pedrojbm/SparkControl/Firmware/Ignitron/resources/ignitron-cheatsheet.pdf

## BOOT

### https://github.com/stangreg/Ignitron

# CheatSheet

This mode will turn the Ignitron into a Bluetooth LE keyboard. All buttons will act like keyboard presses

In AMP mode, Ignitron acts like a Spark AMP and can communicate with the Spark app running on a mobile. New presets can be stored on Ignitron and existing presets can be deleted.

In Manual/FX mode, you can toggle single effects

In Looper mode, Ignitron is connected to your mobile/PC as a bluetooth keyboard. If supported by the respective app on the mobile/PC, the buttons can be freely configured to any function offered by the respective App.

APP Mode is the default
Ignitron mode.
You can switch presets (1-4) and banks (1-n)

### Short Press Long Press

V1.1 Ivan Tarozzi 2024 | Send “1”
AMP MODE | KEYBOARD MODE
Preset1/Drive | Preset2/Drive Preset3/Drive | Preset4/Drive
| REBOOT | LOOPER MODE

## APP MODE Preset Mode

### Bank Up

### Bank Down

### FX MODE

Send “1” | Send “2” | Send “3” | Send “4”
Send “A” | Send “B” | Send “C” | Send “D”

## KEYBOARD MODE

### Send “6”

### Send “5”

### Send “F”

### Send “E”

Send “1” | Send “2” | Send “3” | Send “4”
| REBOOT | | PRESET MODE

## APP MODE Looper Mode

### Send “6”

### Send “5”

### Next Preset

### Prev. Preset

Drive | Modulation | Delay | Reverb
| REBOOT

## APP MODE Manual/FX Mode

Noise gate

Compressor

PRESET MODE

Sel/Store P1 | Sel/Store P2 | Sel/Store P3 | Sel/Store P4
| REBOOT

## AMP MODE

Bank Up

Bank Down
Unload/Delete
