pedrojbm/SparkControl/Hardware/IMG/skull.png

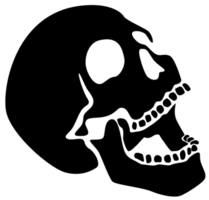
Hardware/IMG/skull.png
