pedrojbm/SparkControl/Hardware/OUT/BLEcontrolV1.xlsx

Comment | Description | Designator | Footprint | JLCPCB Part #（optional）
BH-18650-B1BA002 | BH-18650-B1BA002 | BT1 | BH-18650-B1BA002 | C2988620
1 µF | CAP CER 1UF 25V X7R 0603 | C1, C5, C6, C9 | CAP 0603_1608 | C3015156
4.7 µF | CAP CER 4.7UF 16V X6S 0603 | C2, C3 | CAP 0603_1608 | C3015159
0.1 µF | CAP CER 0.1UF 10V X7R 0603, CAP CER 0.1UF 50V X7R 0603 | C4, C7, C8, C10, C11 | CAP 0603_1608 | C577419
USBLC6-2SC6 | Very low capacitance ESD protection, 3.5 pF, -40 to 125 degC, 6-Pin SOT23, RoHS, Tape and Reel | D1 | SOT95P280X145-6N | C2827654
Blue | LED BLUE 0603 SMD | ON | LED 0603_1608 BLUE | C375446
USB-TYPE-C-017 | 3A 1 Surface Mount 16P Female -25℃~+85℃ Type-C SMD USB Connectors ROHS | J1 | USB-TYPE-C-017 | C2927037
S8050 | Transistor | Q1, Q2 | SOT95P240X115-3N | C364312
4.7 kΩ | RES SMD 4.7K OHM 0.1% 1/10W 0603 | R1, R2, R6, R9, R10, R11, R12, R13, R14, R15, R16, R17, R18 | RES 0603_1608 | C3017722
5.1 kΩ | RES 5.1K OHM 5% 1/10W 0603 | R3, R4 | RES 0603_1608 | C3152170
10 kΩ | RES SMD 10K OHM 1% 1/10W 0603 | R5 | RES 0603_1608 | C2906982
47 kΩ | RES SMD 47K OHM 5% 1/4W 0603 | R7 | RES 0603_1608 | C3152144
1.78 kΩ | RES 1.78K OHM 1% 1/8W 0603 | R8 | RES 0603_1608 | C2974030
12 kΩ | RES 12K OHM 5% 1/10W 0603 | R19, R20, R24, R25 | RES 0603_1608 | C2907097
470 Ω | RES 470 OHM 5% 1/10W 0603 | R21, R22, R23 | RES 0603_1608 | C3017744
BQ24075RGTR | Standalone 1-cell 1.5-A linear charger, Power Path, 4.2-V VBAT and 5.5-V VOUT 16-VQFN -40 to 85 | U1 | QFN50P300X300X100-17N | C15464
ME6211C33M5G-N | Fixed 6V 3.3V 500mA SOT-23-5 Low Dropout Regulators(LDO) RoHS | U2 | SOT95P270X145-5N | C82942
MAX17048G+ | Battery Battery Monitor IC Lithium-Ion 8-TDFN-EP _2x2_ | U3 | SON50P200X200X80-9N | C2682616
ESP32-WROOM-32E_(16MB) | Bluetooth, WiFi 802.11b/g/n, Bluetooth v4.2 +EDR, Class 1, 2 and 3 Transceiver Module 2.4GHz ~ 2.5GHz Integrated, Trace Surface Mount | U4 | XCVR_ESP32-WROOM-32E_(16MB) | C701343
CH340C | USB to serial chip CH340 | U5 | SOIC127P600X180-16N | C7464026
