pedrojbm/SparkControl/Case/Switch/TopCase.SLDPRT

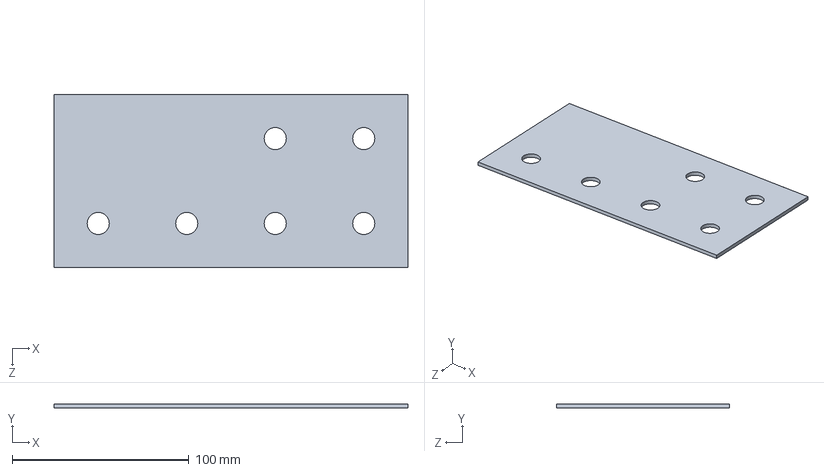
[picture p7: CAD file, 2024-01-24]
Case/Switch/TopCase.SLDPRT
200.0 x 2.54 x 98.0 mm
