pedrojbm/SparkControl/Firmware/Ignitron/hardware/tinyOledBezel.stl

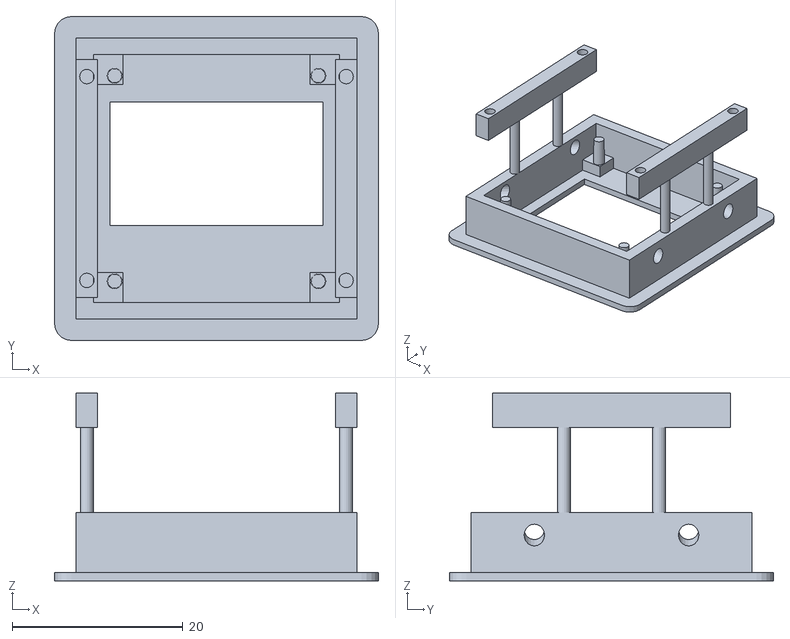
[picture p8: CAD file, 2024-01-24]
Firmware/Ignitron/hardware/tinyOledBezel.stl
38.0 x 38.0 x 22.0
