pedrojbm/SparkControl/Case/AKMAX_Botton.3mf

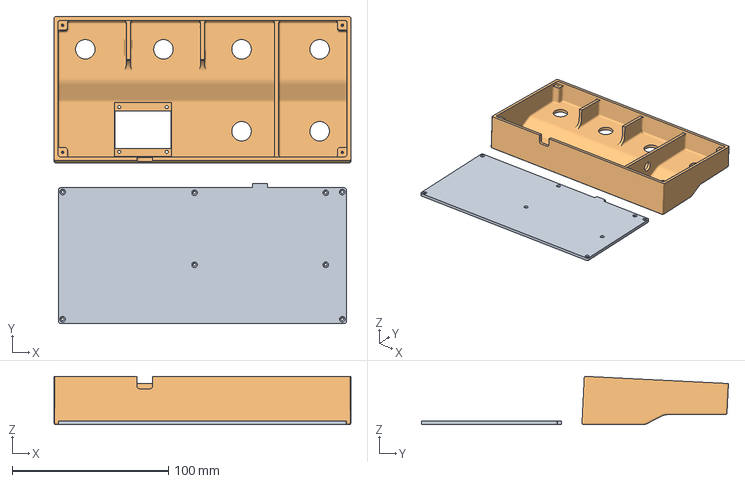
[picture p9: CAD file, 2024-01-24]
Case/AKMAX_Botton.3mf
190.0 x 196.5 x 31.0 mm
Botton.STL
TopCaseV2.STL
