pedrojbm/SparkControl/Case/Botton.SLDPRT

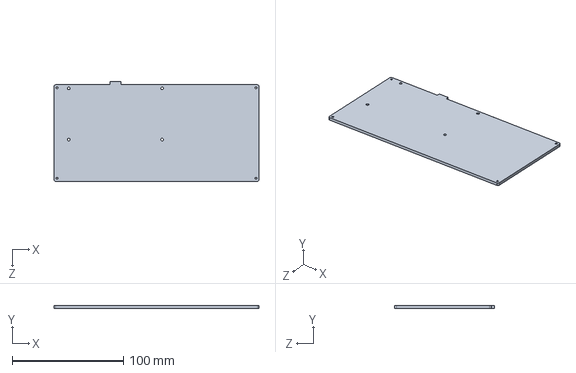
[picture p10: CAD file, 2024-01-24]
Case/Botton.SLDPRT
184.5 x 2.50 x 89.7 mm
