pedrojbm/SparkControl/Case/USB-C and flexed cable.step

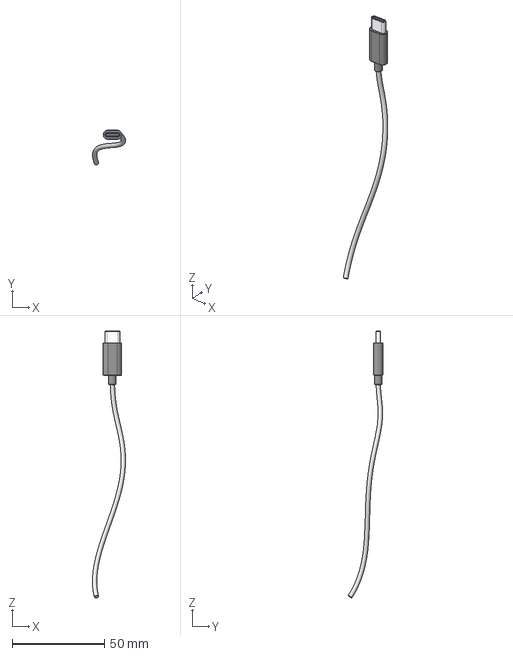
[picture p11: CAD file, 2024-01-24]
Case/USB-C and flexed cable.step
17.9 x 18.8 x 144.6 mm
