pedrojbm/SparkControl/Case/AZ-Delivery - OLED13 IIC.stp

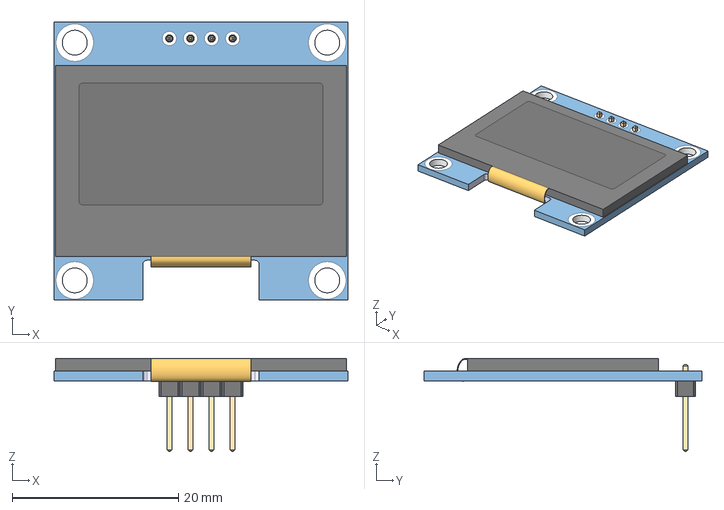
[picture p12: CAD file, 2024-01-24]
Case/AZ-Delivery - OLED13 IIC.stp
35.4 x 33.5 x 11.2 mm
