pedrojbm/SparkControl/Case/Switch/Momentary footswitch.step

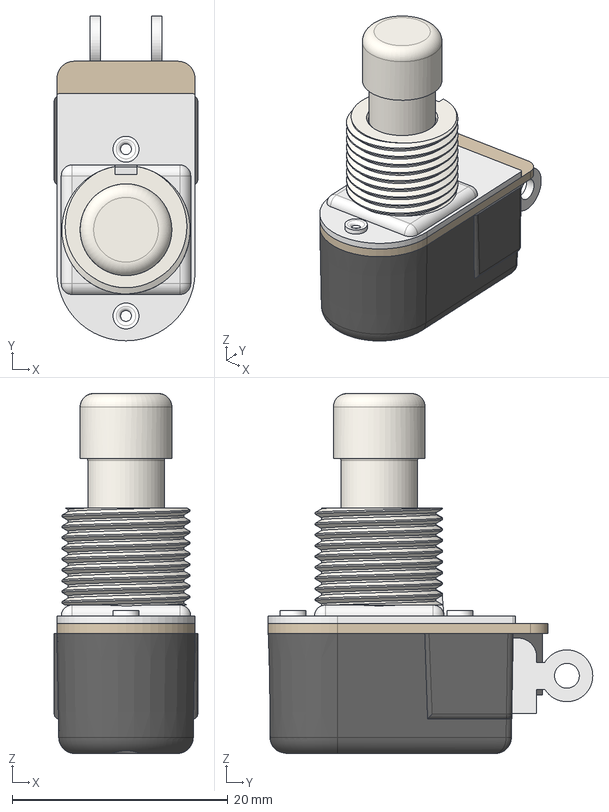
[picture p13: CAD file, 2024-01-24]
Case/Switch/Momentary footswitch.step
13.3 x 30.1 x 33.4 mm
