pedrojbm/SparkControl/Case/Switch/TopCaseV2.SLDPRT

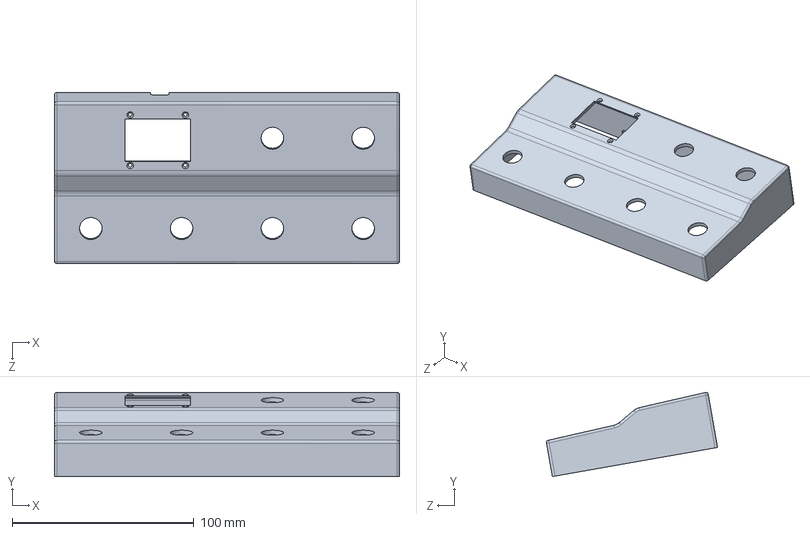
[picture p14: CAD file, 2024-01-24]
Case/Switch/TopCaseV2.SLDPRT
190.0 x 46.3 x 94.3 mm
