pedrojbm/SparkControl/Case/18650 battery.sldprt

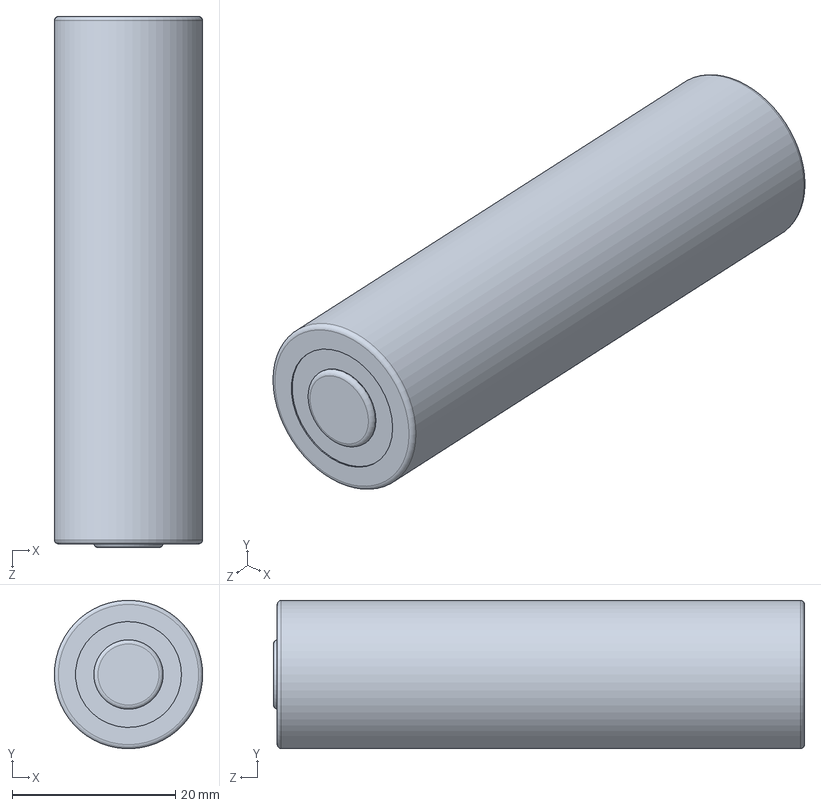
[picture p15: CAD file, 2024-01-24]
Case/18650 battery.sldprt
18.2 x 18.2 x 65.2 mm
