pedrojbm/SparkControl/Case/Switch/M12x1 nut.step

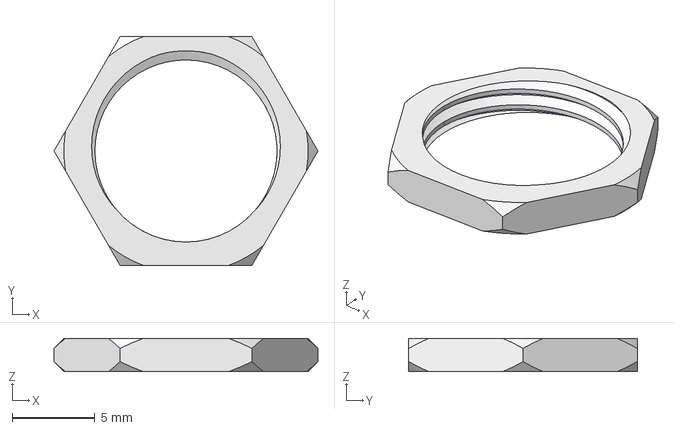
[picture p16: CAD file, 2024-01-24]
Case/Switch/M12x1 nut.step
16.0 x 13.9 x 2.00 mm
