pedrojbm/SparkControl/Case/Switch/12mm spring washer.step

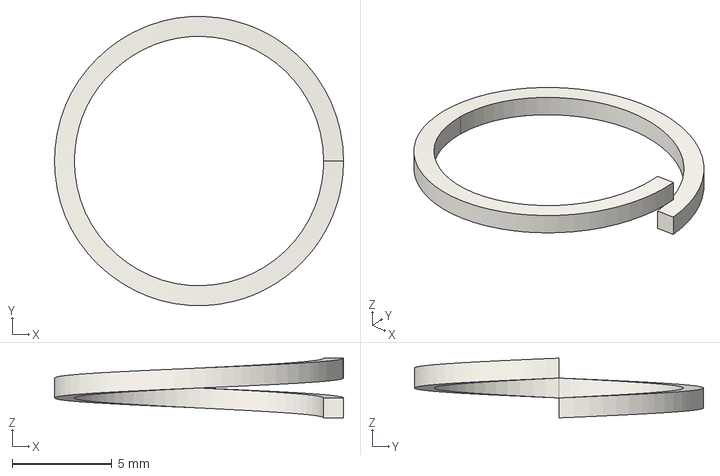
[picture p17: CAD file, 2024-01-24]
Case/Switch/12mm spring washer.step
14.5 x 14.5 x 3.00 mm
