pedrojbm/SparkControl/Case/Switch/M12x1 knurled thumb nut.step

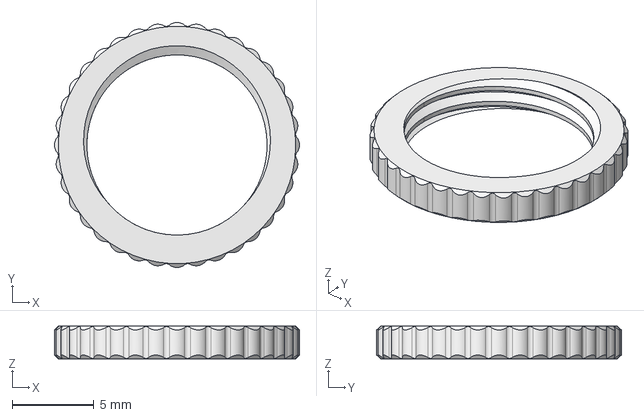
[picture p18: CAD file, 2024-01-24]
Case/Switch/M12x1 knurled thumb nut.step
15.0 x 15.0 x 2.00 mm
