pedrojbm/SparkControl/(list of files, cad)

Other CAD files:
Firmware/Ignitron/hardware/tinyOledBezel.scad
Case/Botton.STL
Case/Switch/12mm spring washer.f3d
Case/Switch/M12x1 knurled thumb nut.f3d
Case/Switch/M12x1 nut.f3d
Case/Switch/Momentary footswitch.f3d
Hardware/PCB/SparkControl_V0.1.x_t
