pedrojbm/SparkControl/Case/Switch/Momentary footswitch assembly.png

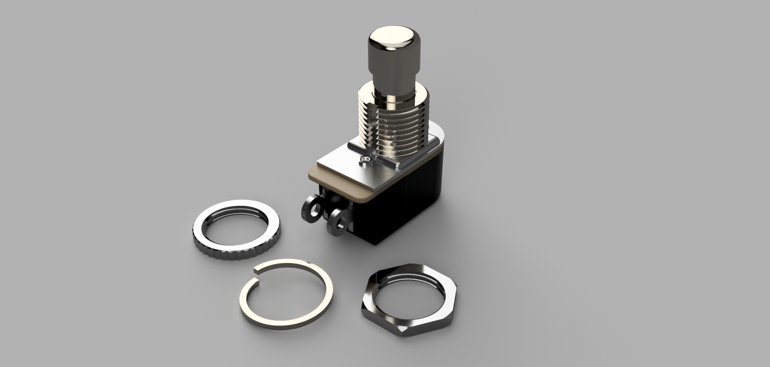
Case/Switch/Momentary footswitch assembly.png
