pedrojbm/SparkControl/Hardware/OUT/SparkControlV1_SCHs.PDF

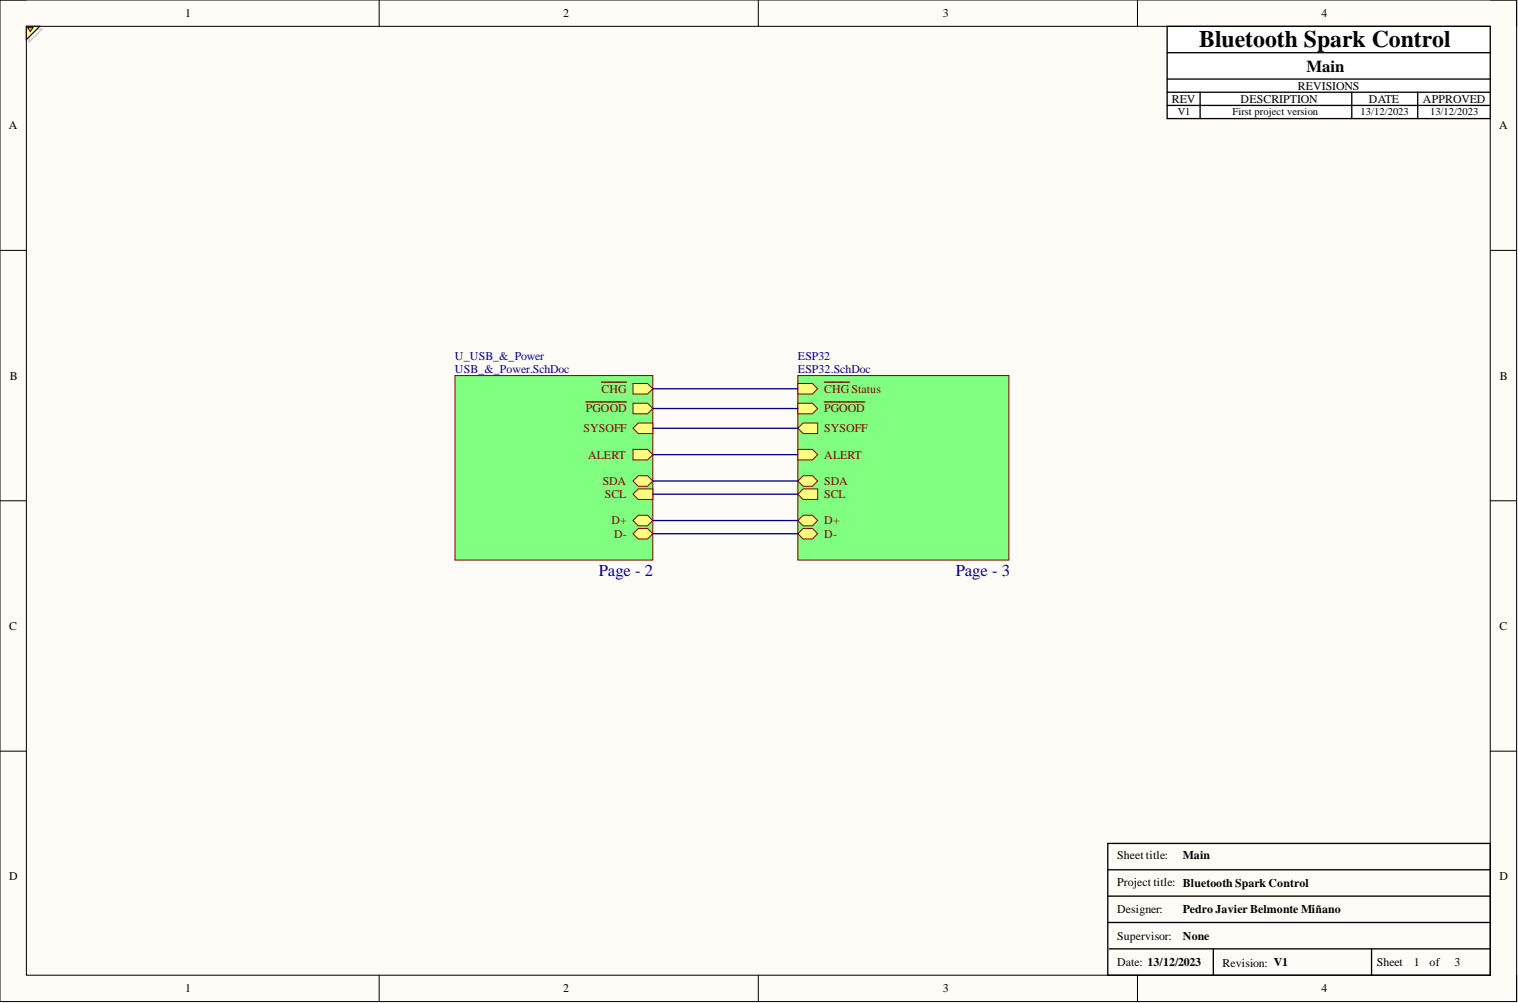
[picture p21: page 1]

REV | DESCRIPTION | DATE | APPROVED
V1 | First project version | 13/12/2023 | 13/12/2023

Pedro Javier Belmonte Miñano

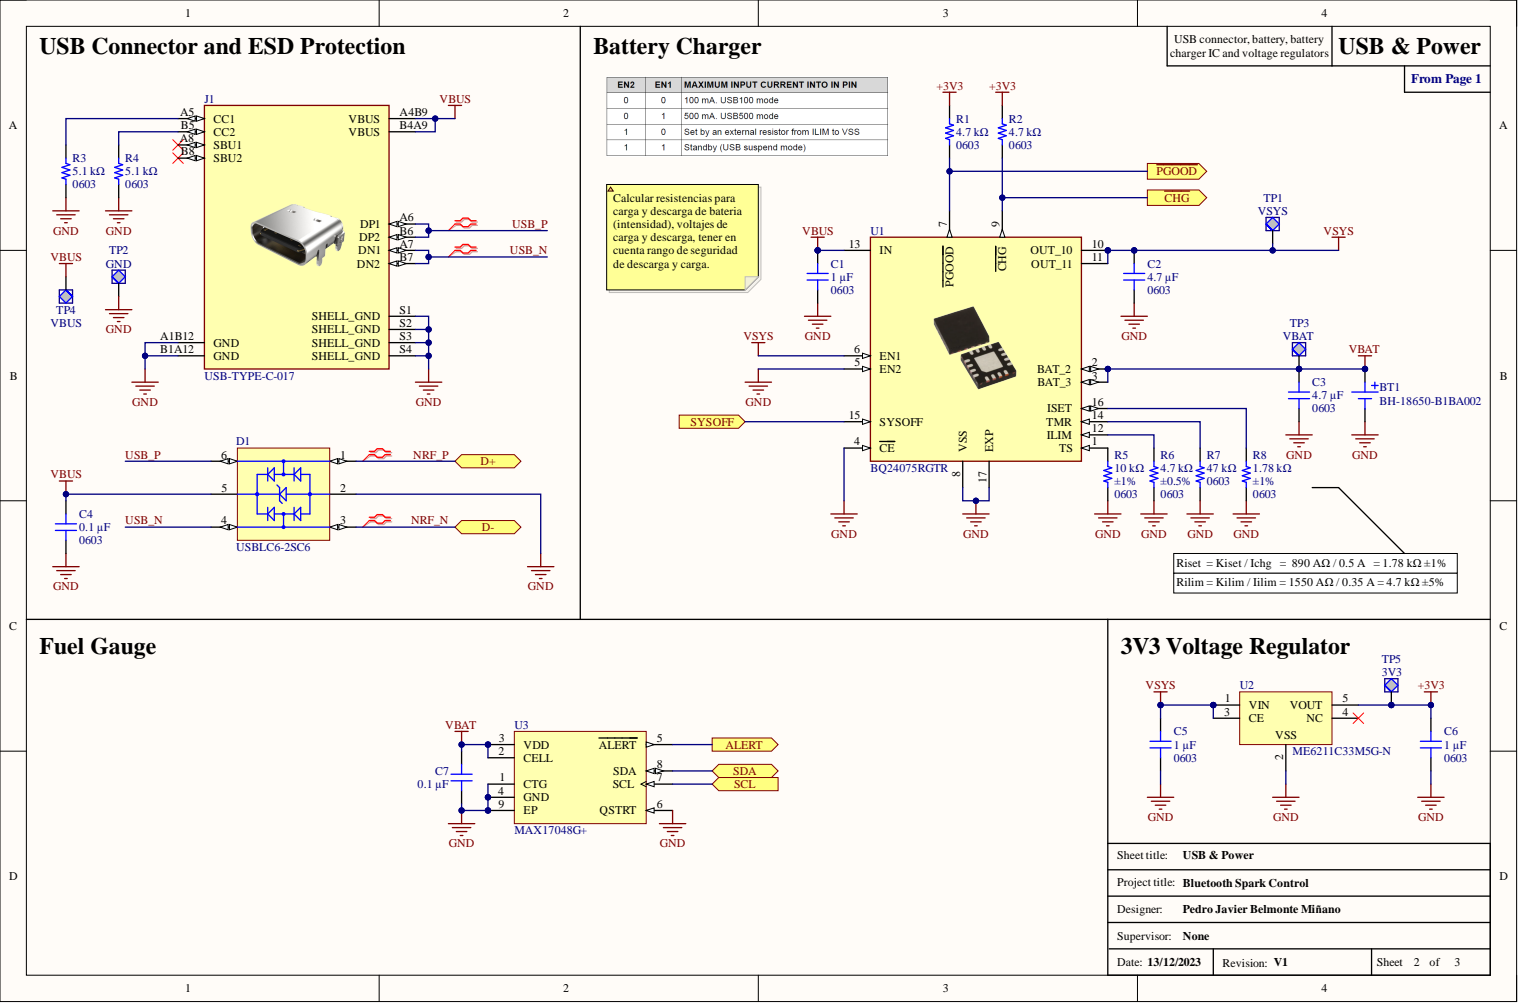
[picture p22: page 2]

1 2

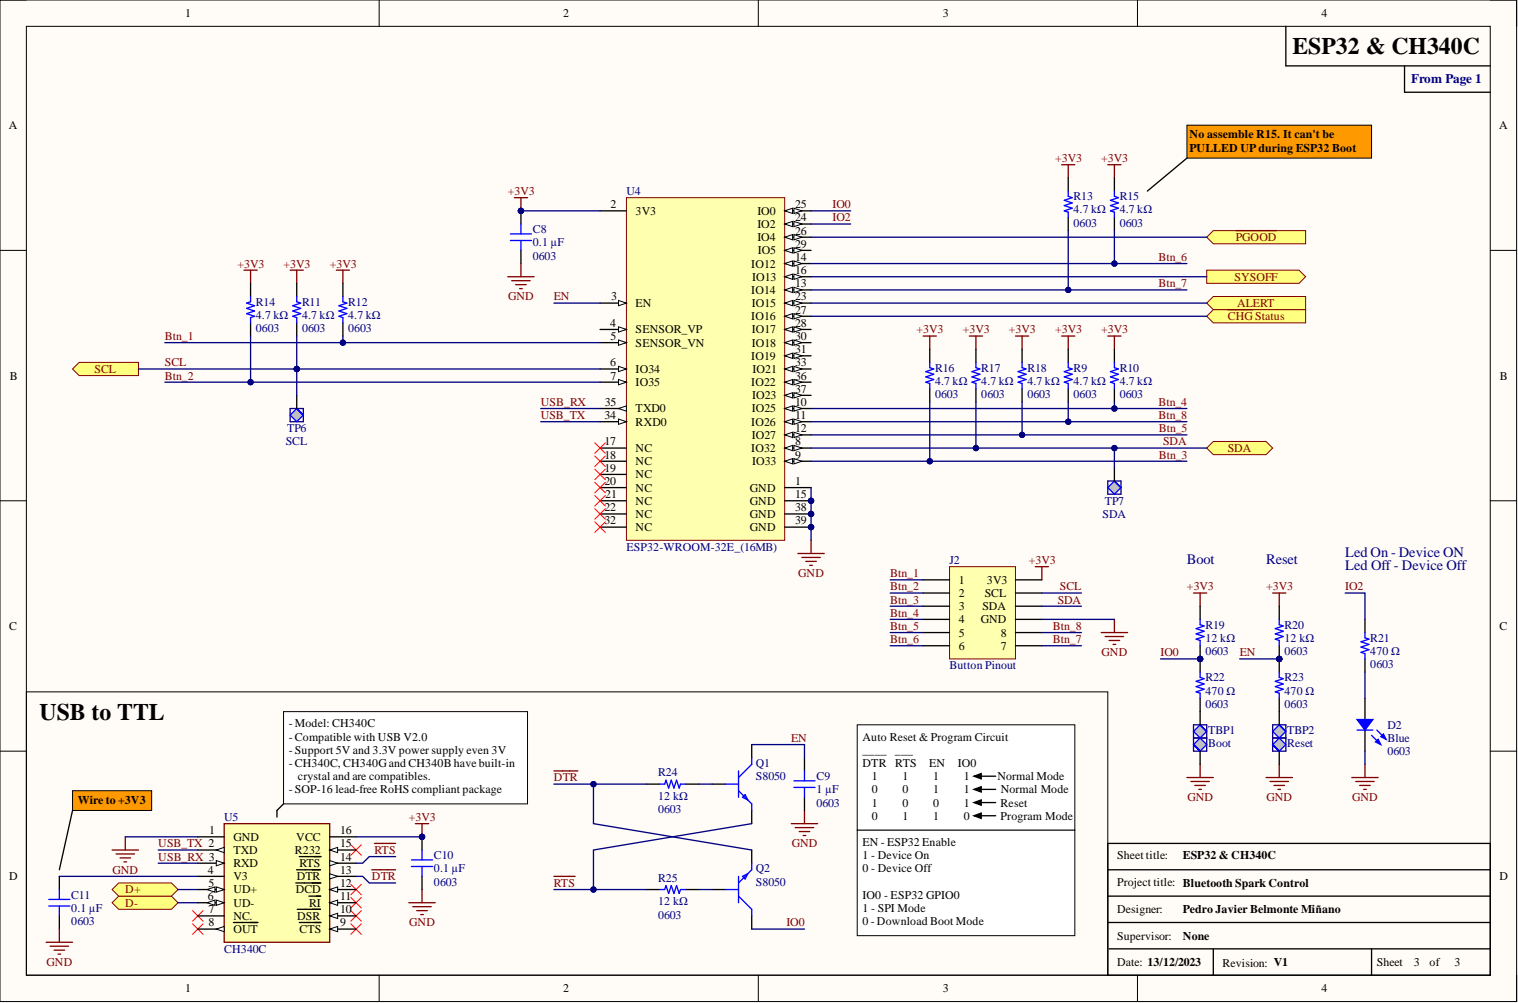
[picture p23: page 3]

1 1
1 2

Dat e : 1 3 / 1 2/2 0 2 3 | Rev i s i o n : V 1 | Shee t o f
