pedrojbm/SparkControl/Hardware/OUT/SparkControlV1.PDF

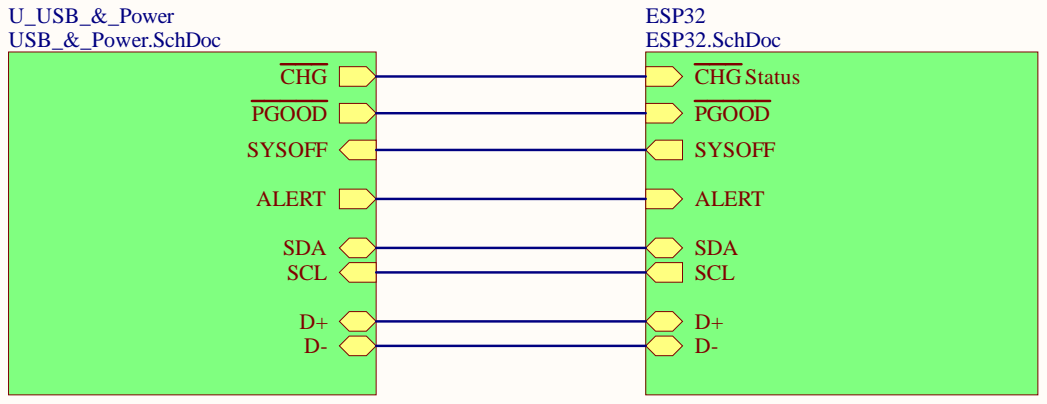
[picture p24: page 1]

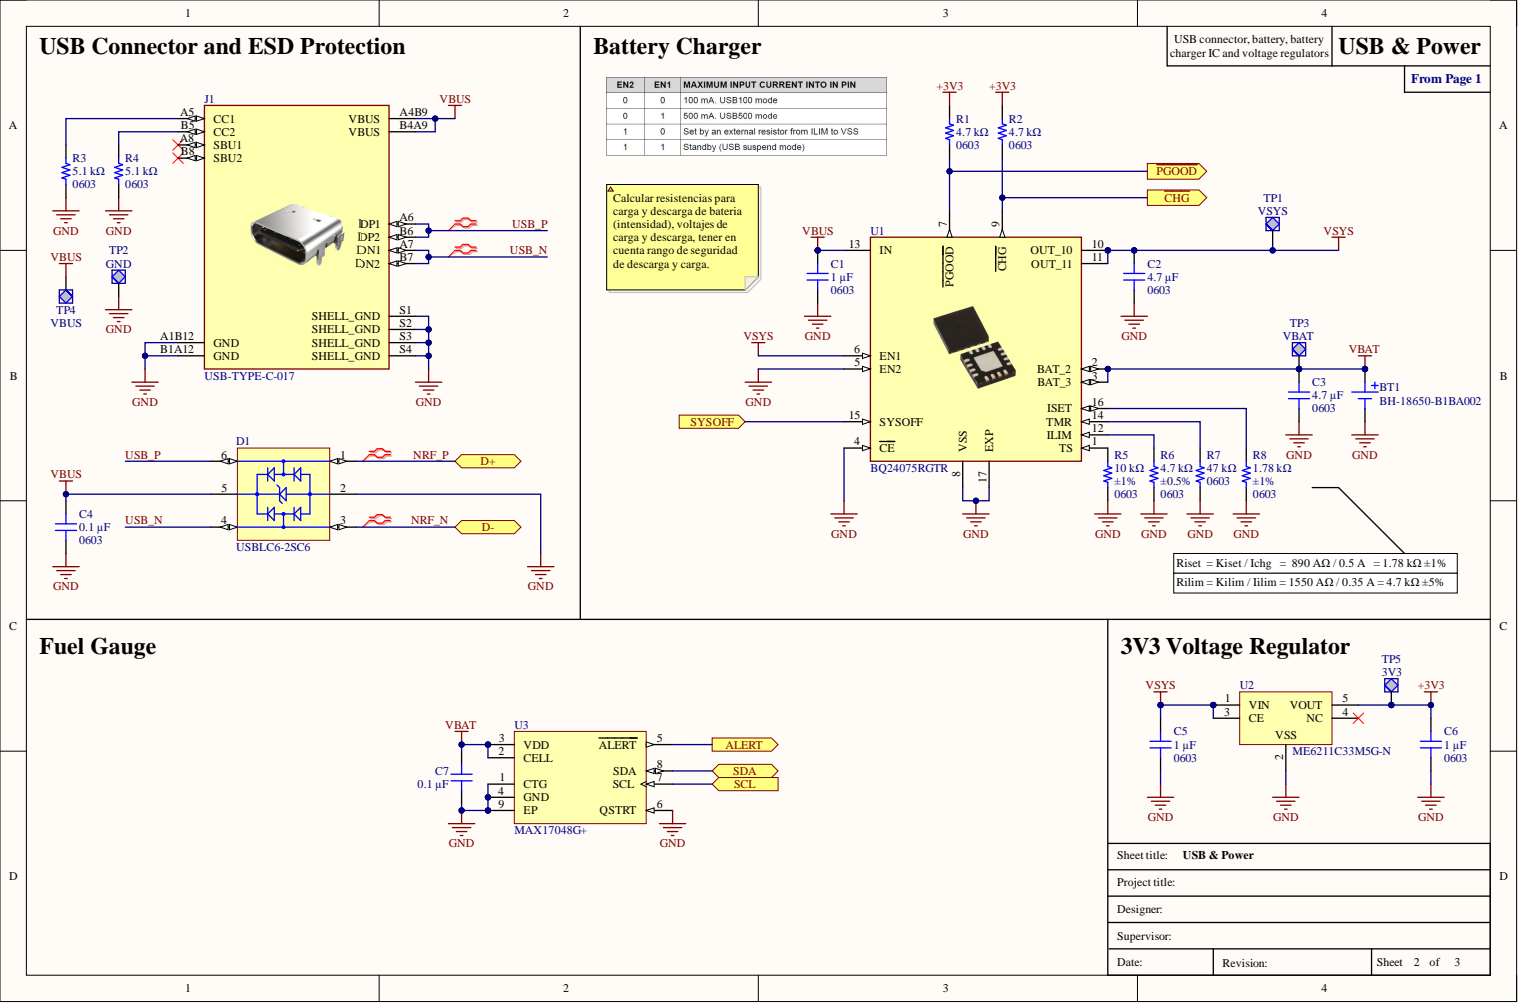
[picture p25: page 2]

1 2

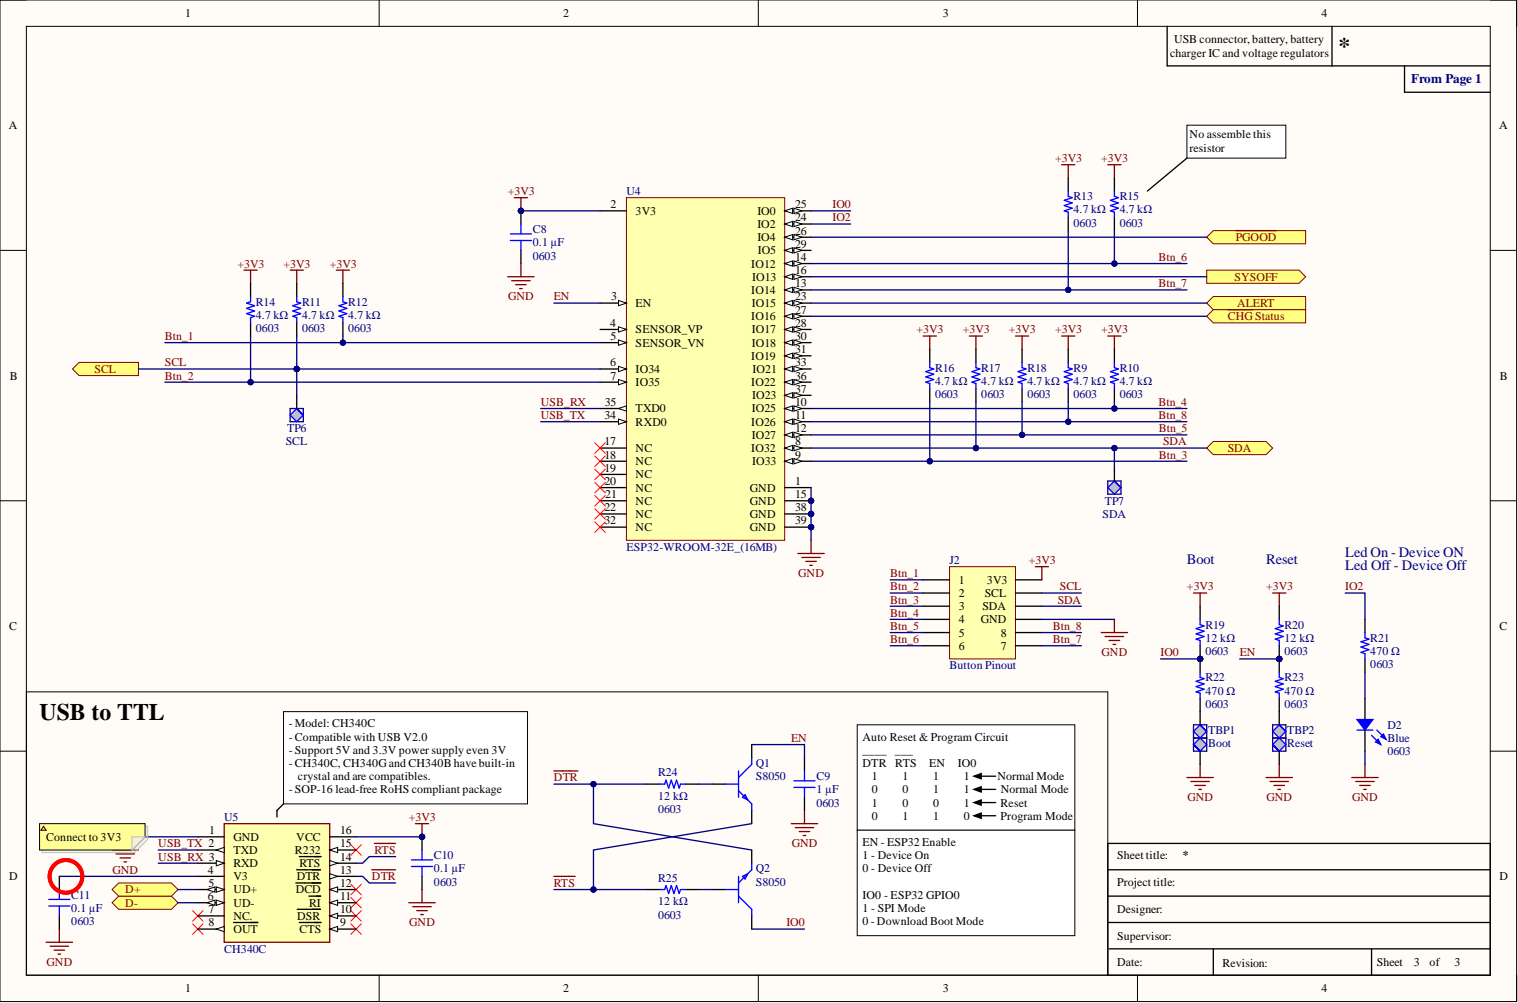
[picture p26: page 3]

1 1
1 2

Dat e : | Rev i s i o n : | Shee t o f
