pedrojbm/SparkControl/(list of files, drawings)

Other design files:
Hardware/History/SCH/Main.~(1).SchDoc
Hardware/PCB/SparkControl_V0.1.PcbDoc
Hardware/SCH/ESP32.SchDoc
Hardware/SCH/Main.SchDoc
Hardware/SCH/USB_&_Power.SchDoc
Hardware/SparkControl.PrjPcb
Hardware/TEMPLATE/PCB_Template.PcbDoc
