pedrojbm/SparkControl/Firmware/Ignitron/hardware/Ignitron.kicad_pcb

## KiCad design Firmware/Ignitron/hardware/Ignitron.kicad_pcb (2024-01-24)

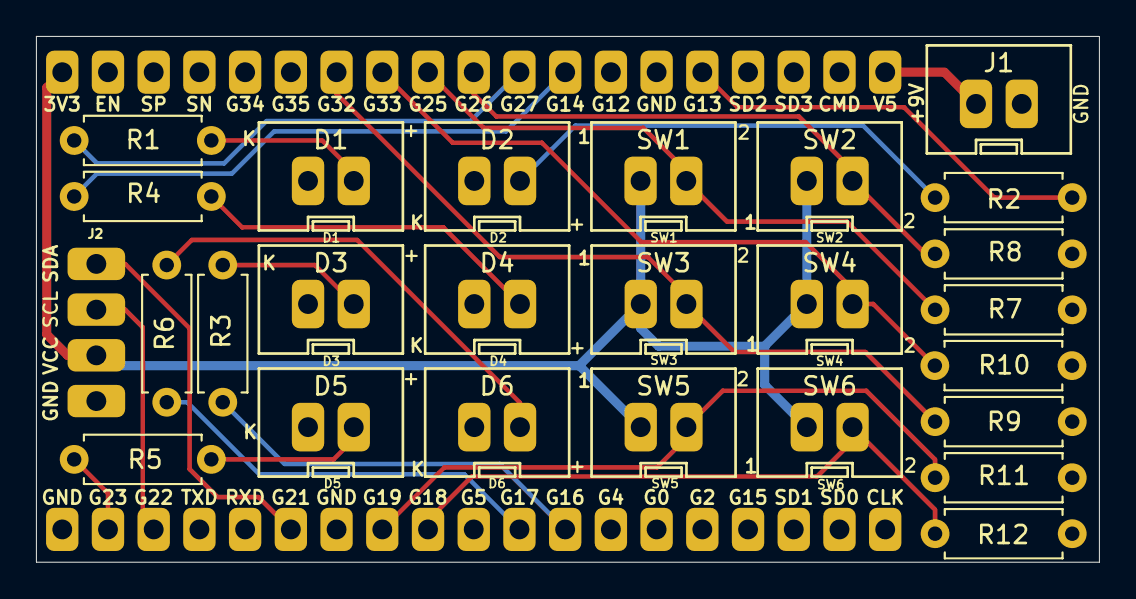
[picture p27: board Ignitron.kicad_pcb from above]

Board: 2 copper layers, 59.1 x 29.2 mm, 27 parts (1 on the bottom side), 23 nets.

Parts:
D1, D2, D3, D4, D5, D6: LED; Conn_Socket_LED
IC1: ESP32-Pinout
J1: PowerIn; Conn_Socket_Power
J2: SSD_1306
R1: R_P1; R_Axial_DIN0207_L6.3mm_D2.5mm_P7.62mm_Horizontal
R2: R_P2; R_Axial_DIN0207_L6.3mm_D2.5mm_P7.62mm_Horizontal
R3: R_P3; R_Axial_DIN0207_L6.3mm_D2.5mm_P7.62mm_Horizontal
R4: R_P4; R_Axial_DIN0207_L6.3mm_D2.5mm_P7.62mm_Horizontal
R5: R_BD; R_Axial_DIN0207_L6.3mm_D2.5mm_P7.62mm_Horizontal
R6: R_BU; R_Axial_DIN0207_L6.3mm_D2.5mm_P7.62mm_Horizontal
R7, R8, R9, R10, R11, R12: 1K; R_Axial_DIN0207_L6.3mm_D2.5mm_P7.62mm_Horizontal
SW1: SW_P1DRV; Conn_Socket_Switch
SW2: SW_P2MOD; Conn_Socket_Switch
SW3: SW_P3DLY; Conn_Socket_Switch
SW4: SW_P4REV; Conn_Socket_Switch
SW5: SW_BDNG; Conn_Socket_Switch
SW6: SW_BUCOM; Conn_Socket_Switch

Connections:
+3V3: IC1.20, J2.2, SW1.1, SW2.1, SW3.1, SW4.1, SW5.1, SW6.1
+5V: IC1.38, J1.1
/G13: IC1.34, R2.1
/G14: IC1.31, R4.1
/G16: IC1.12, R3.1
/G17: IC1.11, R6.1
/G18: IC1.9, R12.1, SW6.2
/G19: IC1.8, R11.1, SW5.2
/G21: IC1.6, J2.4
/G22: IC1.3, J2.3
/G23: IC1.2, R5.1
/G25: IC1.28, R7.1, SW1.2
/G26: IC1.29, R8.1, SW2.2
/G27: IC1.30, R1.1
/G32: IC1.26, R9.1, SW3.2
/G33: IC1.27, R10.1, SW4.2
GND: D1.1, D2.1, D3.1, D4.1, D5.1, D6.1, IC1.1, IC1.7, IC1.33, J1.2, J2.1, R7.2, R8.2, R9.2, R10.2, R11.2, R12.2
unnamed: D1.2, R1.2
unnamed: D2.2, R2.2
unnamed: D3.2, R3.2
unnamed: D4.2, R4.2
unnamed: D5.2, R5.2
unnamed: D6.2, R6.2
