pedrojbm/SparkControl/Firmware/Ignitron/src/SparkDisplayControl.h

/*
 * SparkDisplayControl.h
 *
 *  Created on: 23.08.2021
 *      Author: stangreg
 */

#ifndef SPARKDISPLAYCONTROL_H_
#define SPARKDISPLAYCONTROL_H_

#include <Adafruit_GFX.h>
#include <Adafruit_SH110X.h>
#include "Config_Definitions.h"

#include "SparkDataControl.h"
#include "SparkTypes.h"

// OLED Screen config
#define SCREEN_WIDTH 128 // Display width
#define SCREEN_HEIGHT 64 // Display height
#define OLED_RESET    -1 // Reset pin # (or -1 if sharing Arduino reset pin)
#define DISPLAY_MIN_X_FACTOR -12 // for text size 2, scales linearly with text size

// Splash logo measurements
#define imageWidth 128
#define imageHeight 47

class SparkDataControl;

class SparkDisplayControl {
public:
	SparkDisplayControl();
	SparkDisplayControl(SparkDataControl* dc);
	virtual ~SparkDisplayControl();

	void init(int mode);
	void update(bool isInitBoot = false);
	
	void turnoffDisplay();

	void setDataControl(SparkDataControl *dc) {
			spark_dc = dc;
	}


private:
	static Adafruit_SH1106G display;
	SparkDataControl* spark_dc;
	int activeBank = 1;
	int pendingBank = 1;
	const Preset* activePreset;
	const Preset* pendingPreset;
	const Preset* presetFromApp;
	int presetEditMode;
	int buttonMode = 1;
	int activePresetNum = 1;
	int selectedPresetNum = 1;
	int opMode = 1;
	int currentBTMode = 0;
	bool isBTConnected = false;
	KeyboardMapping mapping;

	std::string primaryLineText;
	const Preset* primaryLinePreset;
	std::string secondaryLineText;
	const Preset* secondaryLinePreset;
	std::string currentBTModeText;

	std::string lowerButtonsShort;
	std::string lowerButtonsLong;
	std::string upperButtonsShort;
	std::string upperButtonsLong;

	std::string lastKeyboardButtonPressed;
	unsigned long keyboardPressedTimestamp = 0;
	int showKeyboardPressedInterval = 500;
	bool showKeyboardPressedFlag = false;

	unsigned long previousMillis = 0;
	int showMessageInterval = 2000;
	bool showMsgFlag = false;

	//DISPLAY variables x1 for the first line, x2 for the second line
	int display_x1 = 0;
	int display_minX1 = DISPLAY_MIN_X_FACTOR * 10;
	int display_scroll_num1 = 1; // scroll speed, make bigger to speed up the scroll

	int display_x2 = 0;
	int display_minX2 = DISPLAY_MIN_X_FACTOR * 10;
	int display_scroll_num2 = 1; // scroll speed, make bigger to speed up the scroll

	int text_scroll_limit = 11;

	int text_row_1_timestamp = 0;
	int text_row_2_timestamp = 0;
	int text_scroll_delay = 3500;
	std::string text_filler = "   ";
	std::string previous_text1 = "";
	std::string previous_text2 = "";

	double batterySOC = 0;
	std::string batterySOCtext;
	bool CHG;
	bool PGOOD;

	SparkDataControl* dataControl() {return spark_dc;}
	void showInitialMessage();
	void showConnection();
	void showBatteryState();
	void showBankAndPresetNum();
	void showPresetName();
	void showFX_SecondaryName();
	void updateTextPositions();

	void showPressedKey();
	void initKeyboardLayoutStrings();
	void showKeyboardLayout();

	void drawCentreTextInPos(const char *buf, int x, int y);
	void drawCentreString(const char *buf, int y, int offset = 0);
	void drawRightAlignedString(const char *buf, int y, int offset = 0);
	void drawInvertBitmapColor(int16_t x, int16_t y, const uint8_t *bitmap,
			int16_t w, int16_t h, uint16_t color);

	const unsigned char epd_bitmap_Ignitron_Logo[768] PROGMEM = {
		// 'Ignitron_logo_small, 128x47px
		0x00, 0x00, 0x00, 0x00, 0x00, 0x00, 0x00, 0x00, 0x00, 0x00, 0x00, 0x00, 0x00, 0x00, 0x00, 0x00, 
		0x00, 0x00, 0x00, 0x00, 0x00, 0x00, 0x00, 0x00, 0x0c, 0x34, 0x70, 0x00, 0x00, 0x00, 0x00, 0x00, 
		0x00, 0x00, 0x00, 0x00, 0x10, 0x00, 0x00, 0x00, 0x1f, 0xfe, 0x7f, 0xf8, 0x00, 0x00, 0x00, 0x00, 
		0x00, 0x00, 0x00, 0x02, 0xff, 0x88, 0x00, 0xfc, 0x1f, 0xff, 0xff, 0xf8, 0x00, 0x00, 0x00, 0x00, 
		0x00, 0x00, 0x00, 0x03, 0xff, 0xff, 0xf1, 0xff, 0xfe, 0x07, 0xff, 0xfc, 0x00, 0x00, 0x00, 0x00, 
		0x00, 0x00, 0x00, 0x07, 0x03, 0xe0, 0xf9, 0xe1, 0xfc, 0x03, 0xff, 0xfc, 0x00, 0x00, 0x00, 0x00, 
		0x00, 0x00, 0x00, 0x06, 0x01, 0xe0, 0x1d, 0xc0, 0xfc, 0x03, 0xe3, 0x0c, 0x00, 0x00, 0x00, 0x00, 
		0x00, 0x00, 0x00, 0x06, 0x31, 0xe0, 0x0d, 0xc0, 0xfc, 0x63, 0xe3, 0x1c, 0x00, 0x00, 0x00, 0x00, 
		0x00, 0x00, 0x00, 0x06, 0x30, 0xe3, 0x0d, 0xc0, 0xfc, 0x61, 0xf2, 0x1c, 0x00, 0x00, 0x00, 0x00, 
		0x00, 0x00, 0x00, 0x06, 0x1b, 0xe3, 0x0d, 0xc0, 0xfc, 0x63, 0xe2, 0x3c, 0x00, 0x00, 0x00, 0x00, 
		0x00, 0x00, 0x00, 0x06, 0x0f, 0xe3, 0x1f, 0xc4, 0xfc, 0x03, 0xe2, 0x38, 0x00, 0x00, 0x00, 0x00, 
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
		0x3e, 0x00, 0x7f, 0x00, 0x80, 0x80, 0x80, 0x80, 0x80, 0x80, 0x80, 0x80, 0xbe, 0x80, 0xbe, 0x80, 
		0x80, 0x80, 0xbe, 0x80, 0xbe, 0x80, 0x80, 0x80, 0xbe, 0x80, 0xbe, 0x80, 0x80, 0x80, 0x7f, 0x00
	};
};

#endif /* SPARKDISPLAYCONTROL_H_ */
