pedrojbm/SparkControl/(commit log)

2024-01-24 V0.6 Added firmware and case design
    - Added basic firmware
    - Added prototype design enclosure
    [12mm spring washer.f3d, 12mm spring washer.step, 18650 battery.sldprt, AKMAX_Botton.3mf, AZ-Delivery - OLED13 IIC.stp, Botton.SLDPRT, Botton.STL, EffectReference.csv]
2024-01-30 Firmware Update V1.1: Display working
    - Added custom i2c pins
2024-01-31 Firmware Update V1.2: SH1106 display driver
    - Display control library updated to work with SH1106 display driver.
2024-02-18 Firmware Update V1.3: SH1106 display driver
    - Added battery management library
    - Modified SparkDataControl to manage battery data
    - Modified SparkDisplayControl to show battery status and icons
2024-02-18 Firmware Update V1.4
    - New boot logo
    - Added charging status and icon
2024-02-19 Firmware Update V1.5
    - Added power off
2025-02-07 V0.61 - Small sch and firmware changes
    [ESP32.SchDoc, Main.SchDoc, Main.~(1).SchDoc, SparkControl.PrjPcb, SparkControl_V0.1.PcbDoc]
